M1118/DynaVan/Circuit Diagram.png

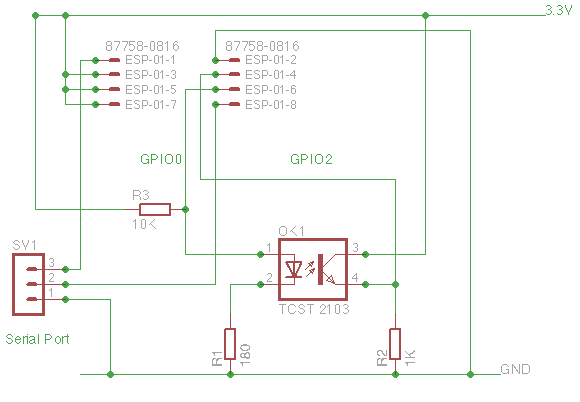
Circuit Diagram.png
